appideasDOTcom/printery/images/A-Measurements.JPG

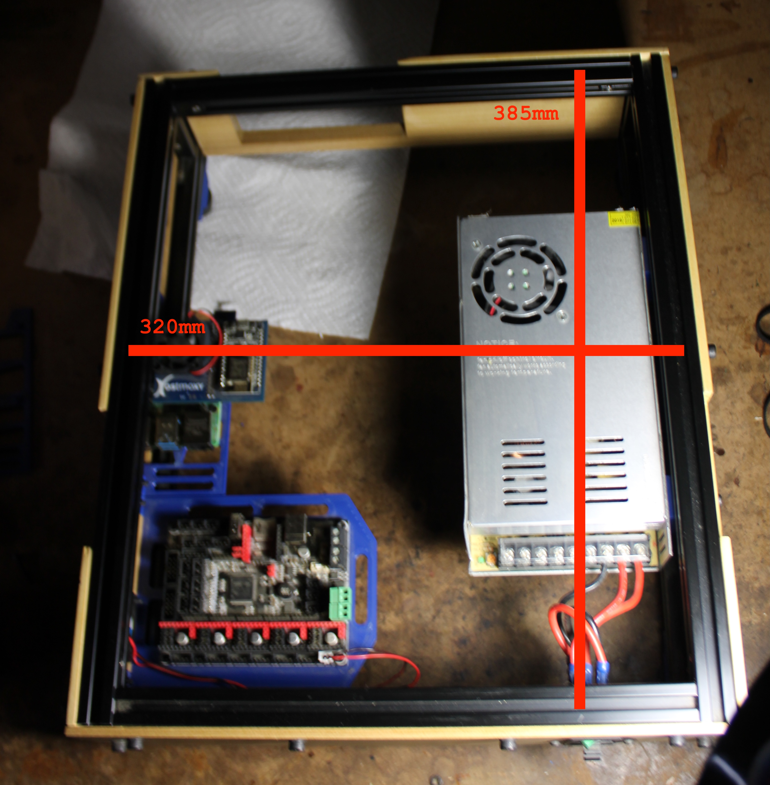
images/A-Measurements.JPG
