appideasDOTcom/printery/images/B-Electronics.JPG

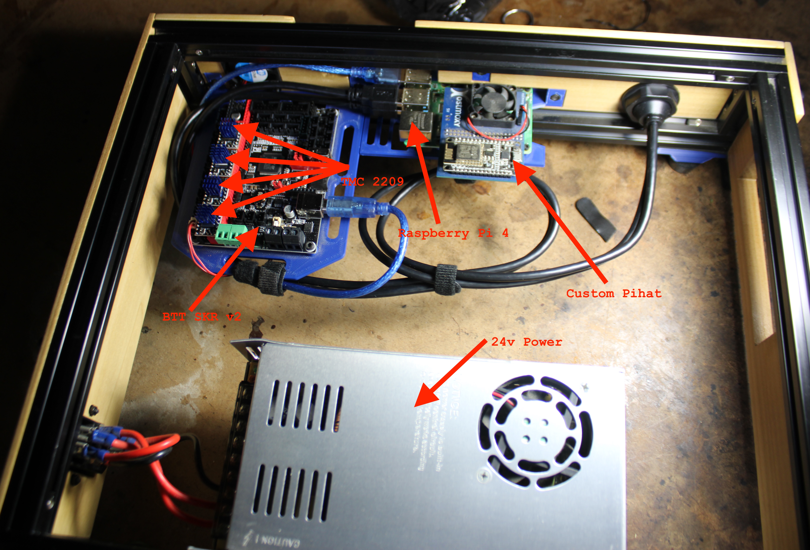
images/B-Electronics.JPG
