appideasDOTcom/printery/images/C-Front.JPG

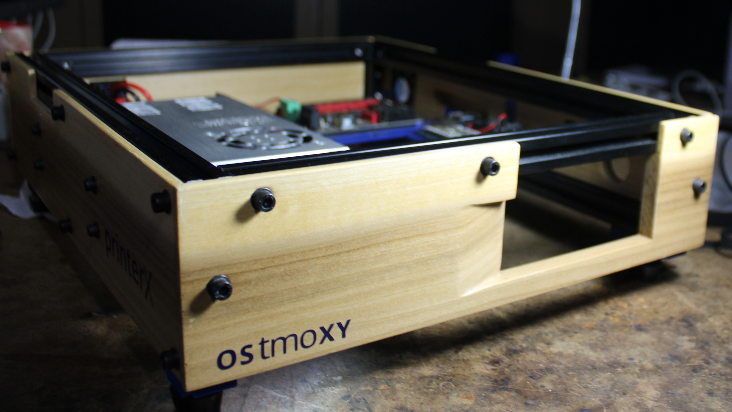
images/C-Front.JPG
