appideasDOTcom/printery/images/D-Right.JPG

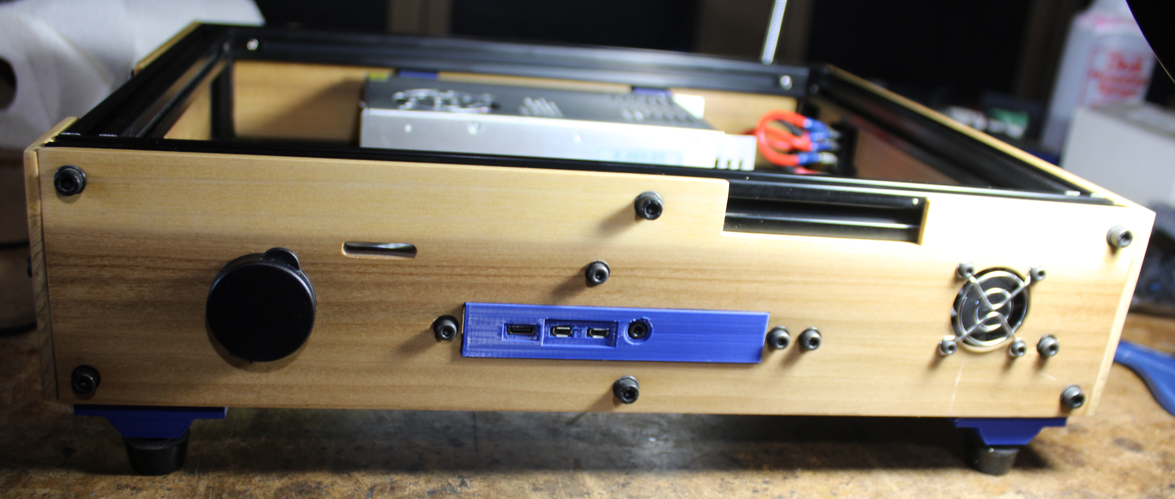
images/D-Right.JPG
