appideasDOTcom/printery/images/ZZ-Creality K1 Timing Belt Reference.png

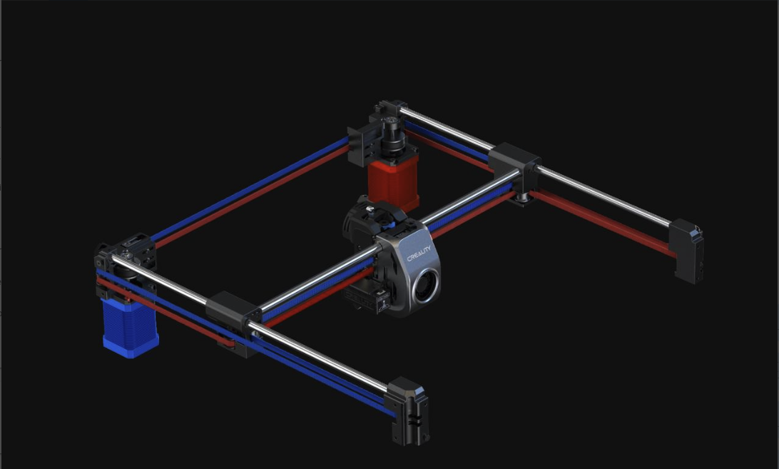
images/ZZ-Creality K1 Timing Belt Reference.png
