appideasDOTcom/printery/models/hotend/strain-gauge-interface.stl

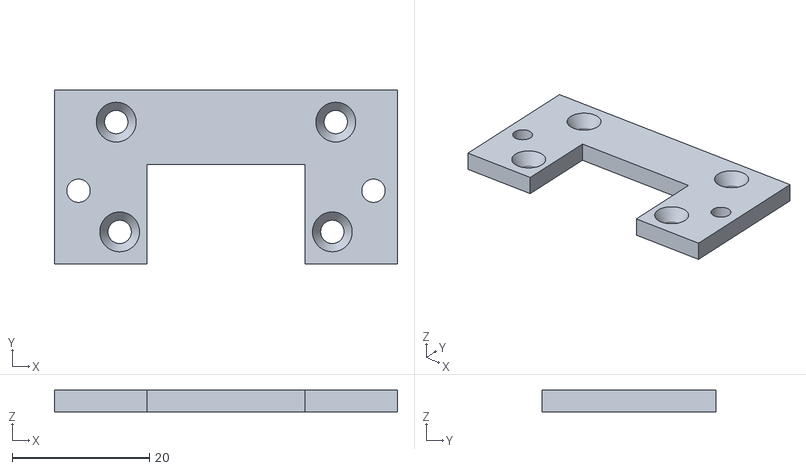
[picture p6: CAD file, 2026-07-26]
models/hotend/strain-gauge-interface.stl
50.0 x 25.4 x 3.20
