appideasDOTcom/printery/models/output/printerX/enclosure/Right panel.stl

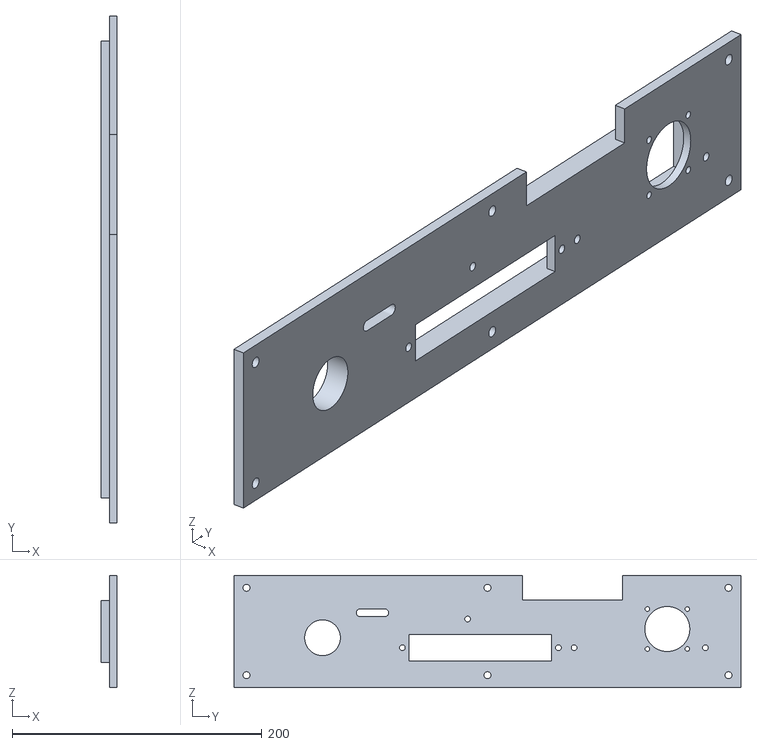
[picture p7: CAD file, 2026-06-04]
models/output/printerX/enclosure/Right panel.stl
12.9 x 406.0 x 90.0
