appideasDOTcom/printery/models/output/printerX/Z axis frame brace x4.stl

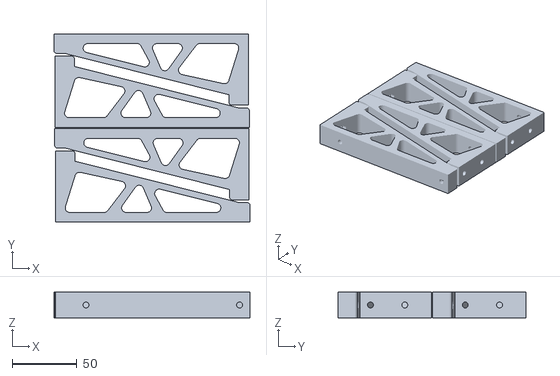
[picture p8: CAD file, 2026-06-19]
models/output/printerX/Z axis frame brace x4.stl
151.2 x 145.3 x 20.0
