appideasDOTcom/printery/models/output/y-rod-mount-A.stl

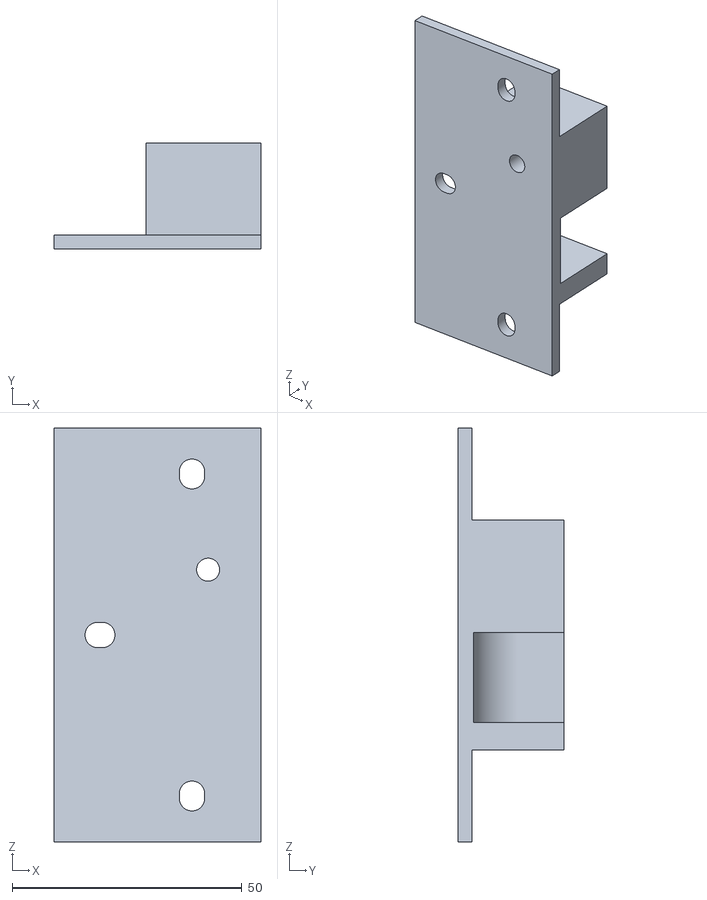
[picture p9: CAD file, 2026-07-26]
models/output/y-rod-mount-A.stl
45.0 x 23.0 x 90.0
