appideasDOTcom/printery/models/output/printerX/Z axis frame brace x2.stl

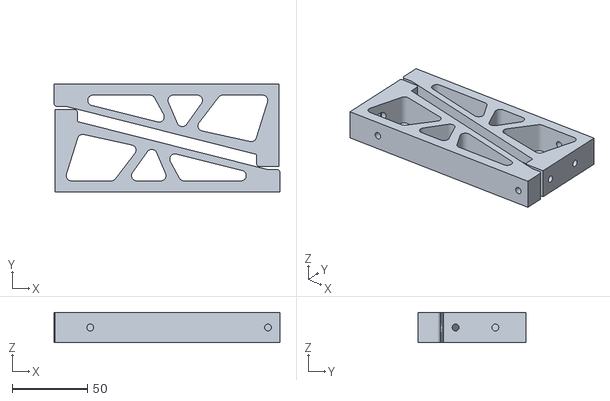
[picture p11: CAD file, 2026-06-19]
models/output/printerX/Z axis frame brace x2.stl
150.7 x 72.2 x 20.0
