appideasDOTcom/printery/models/output/printerX/enclosure/Front panel.stl

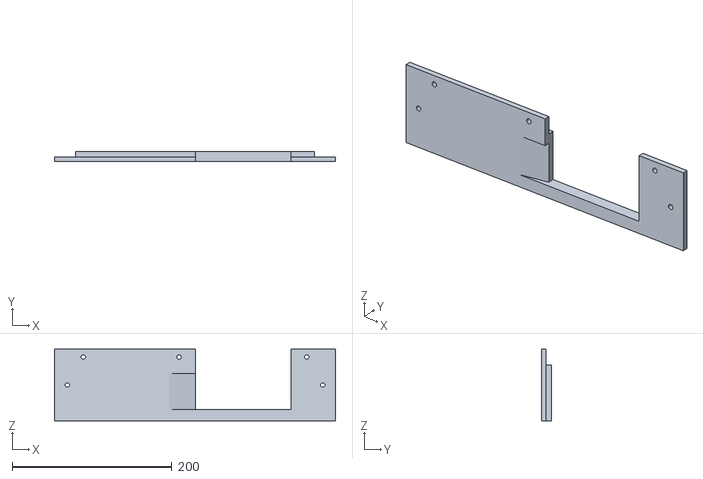
[picture p12: CAD file, 2026-06-04]
models/output/printerX/enclosure/Front panel.stl
352.0 x 12.9 x 90.0
