appideasDOTcom/printery/models/output/printerX/frame-pi-mount.stl

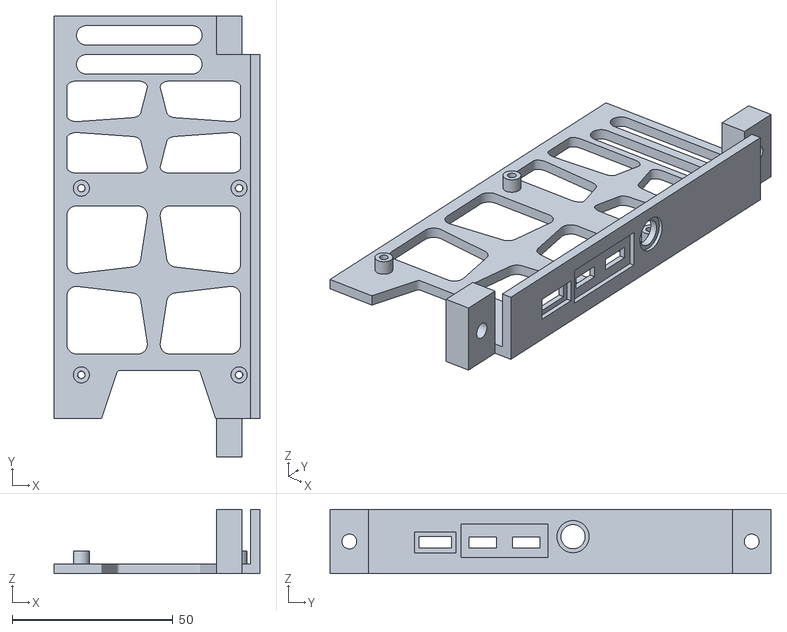
[picture p13: CAD file, 2026-06-18]
models/output/printerX/frame-pi-mount.stl
64.0 x 137.0 x 20.0
