appideasDOTcom/printery/models/output/printerX/enclosure/Top panel.stl

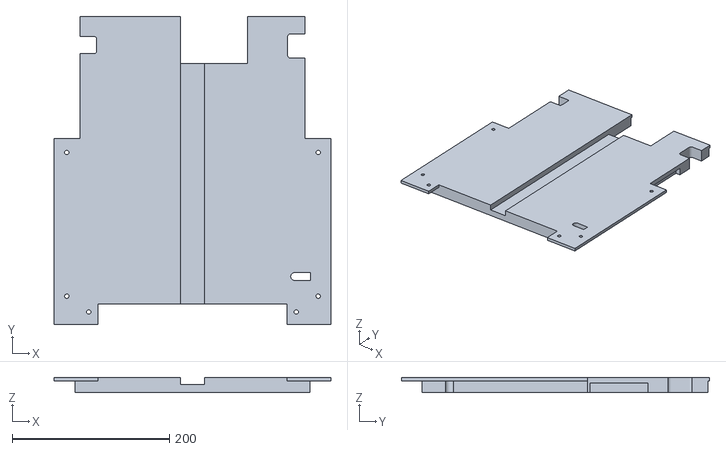
[picture p14: CAD file, 2026-06-04]
models/output/printerX/enclosure/Top panel.stl
352.0 x 392.0 x 19.2
