appideasDOTcom/printery/models/output/printerX/frame-controller-mount.stl

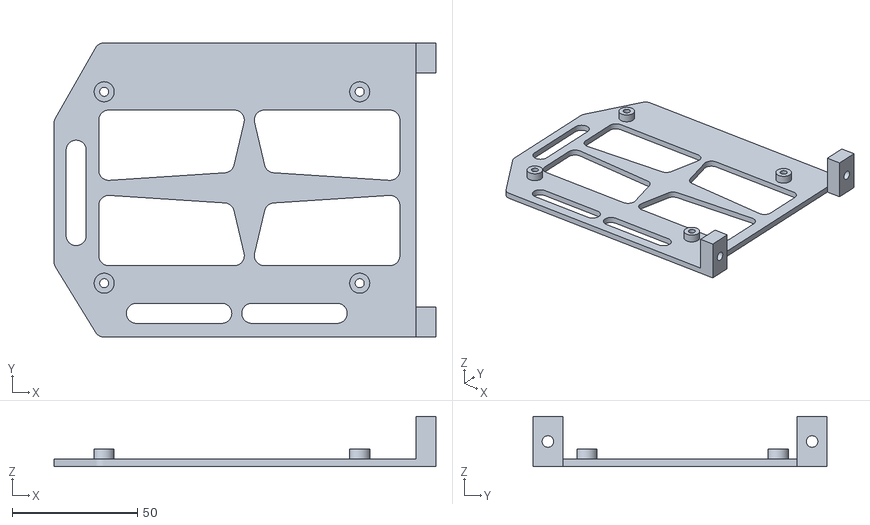
[picture p15: CAD file, 2026-06-18]
models/output/printerX/frame-controller-mount.stl
152.2 x 117.3 x 20.0
