appideasDOTcom/printery/models/output/printerX/frame-psu-mount-block.stl

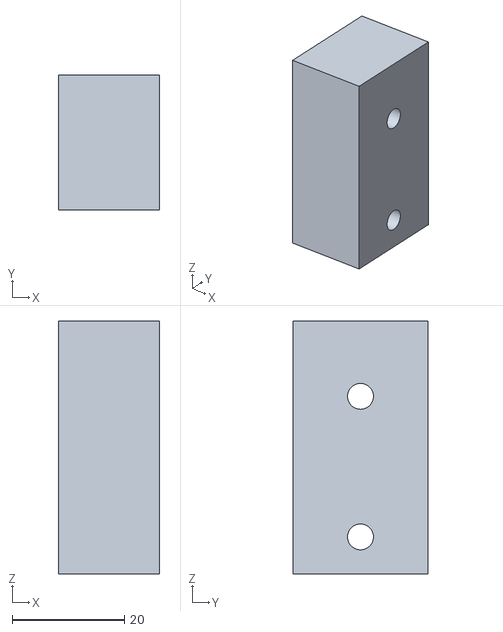
[picture p16: CAD file, 2026-06-18]
models/output/printerX/frame-psu-mount-block.stl
18.0 x 24.0 x 45.0
