appideasDOTcom/printery/models/output/z-belt-tensioner.stl

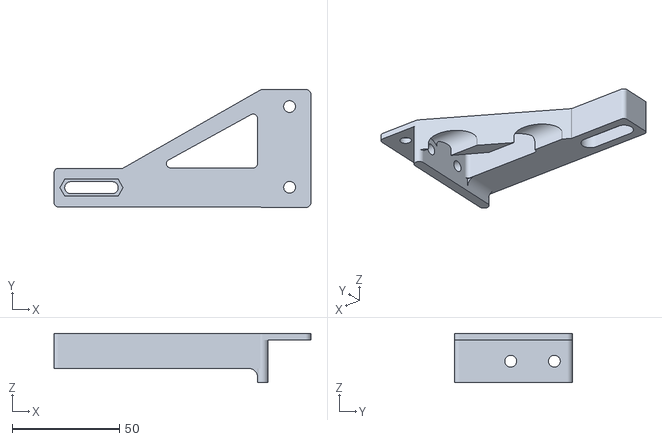
[picture p17: CAD file, 2026-06-29]
models/output/z-belt-tensioner.stl
120.0 x 55.2 x 23.0
