appideasDOTcom/printery/models/output/front-crossbar-AB.stl

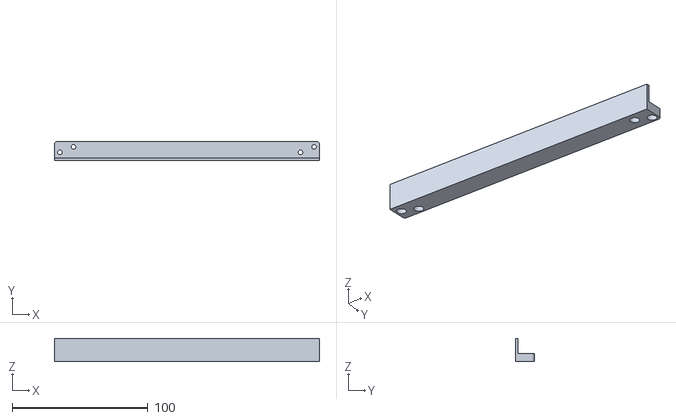
[picture p18: CAD file, 2026-06-27]
models/output/front-crossbar-AB.stl
195.0 x 14.0 x 17.2
