appideasDOTcom/printery/models/output/printerX/frame-tft-mount.stl

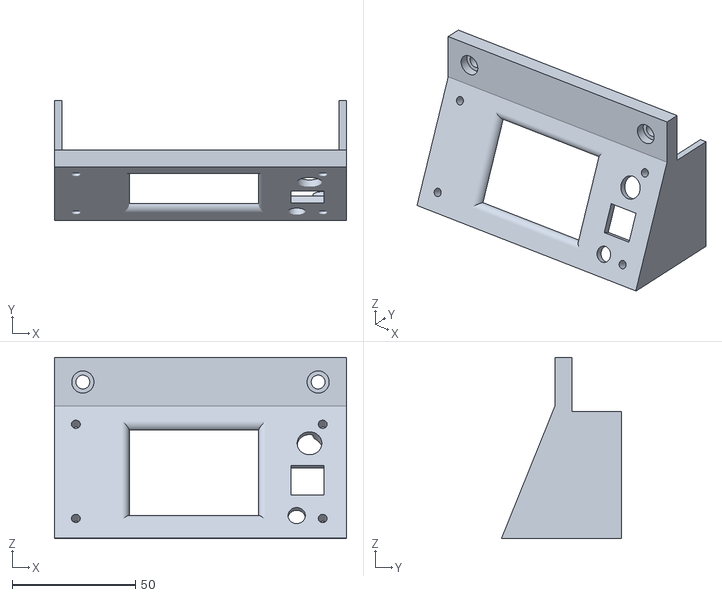
[picture p19: CAD file, 2026-06-18]
models/output/printerX/frame-tft-mount.stl
118.4 x 48.6 x 73.5
