appideasDOTcom/printery/models/output/printerX/Z axis frame brace.stl

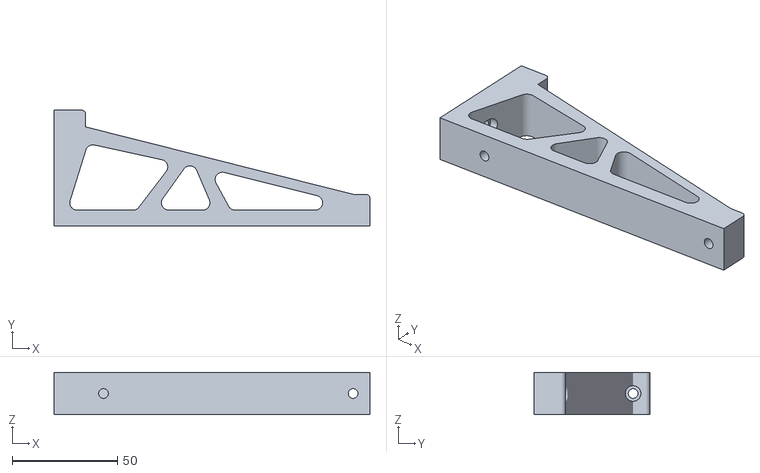
[picture p20: CAD file, 2026-06-04]
models/output/printerX/Z axis frame brace.stl
150.0 x 55.0 x 20.0
