appideasDOTcom/printery/models/output/z-carriage-sled-LEFT.stl

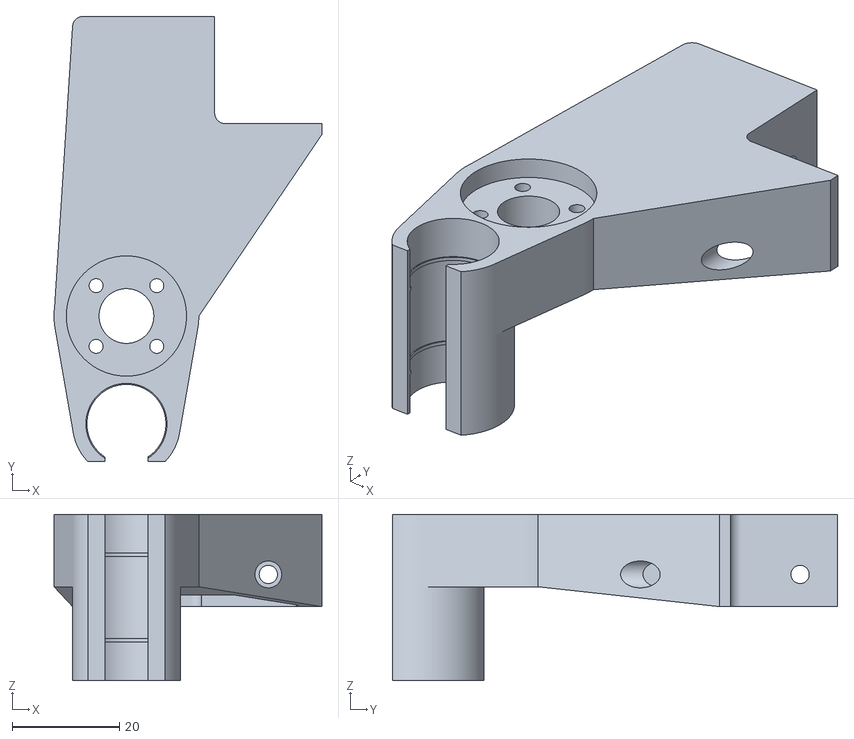
[picture p21: CAD file, 2026-06-27]
models/output/z-carriage-sled-LEFT.stl
50.0 x 83.0 x 31.0
