appideasDOTcom/printery/models/output/corner-bracket-D.stl

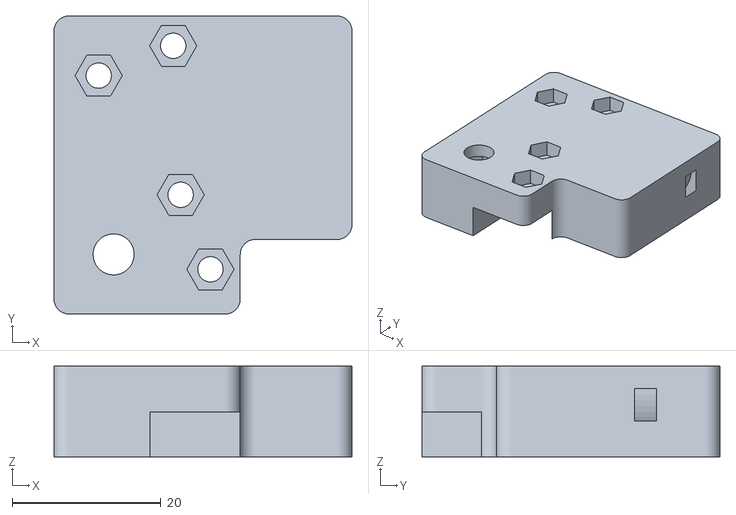
[picture p22: CAD file, 2026-06-27]
models/output/corner-bracket-D.stl
40.0 x 40.0 x 12.2
