appideasDOTcom/printery/models/output/printerX/Frame foot mount.stl

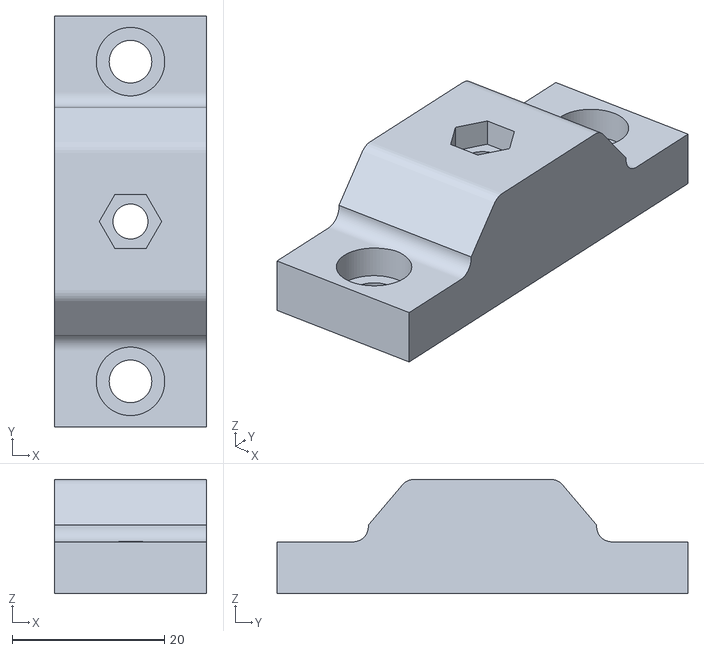
[picture p23: CAD file, 2026-06-04]
models/output/printerX/Frame foot mount.stl
20.0 x 54.0 x 15.0
