appideasDOTcom/printery/models/output/corner-bracket-B.stl

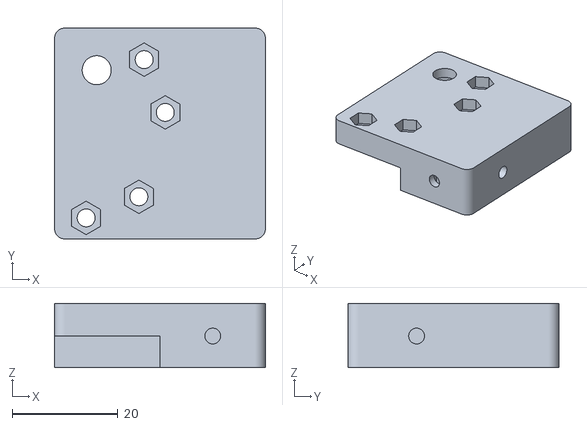
[picture p24: CAD file, 2026-06-27]
models/output/corner-bracket-B.stl
40.0 x 40.0 x 12.2
