appideasDOTcom/printery/models/output/corner-bracket-A.stl

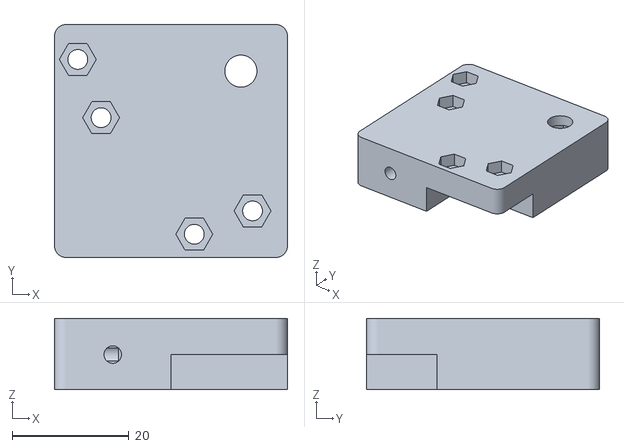
[picture p25: CAD file, 2026-06-27]
models/output/corner-bracket-A.stl
40.0 x 40.0 x 12.2
