appideasDOTcom/printery/models/output/printerX/608 bearing spacer.stl

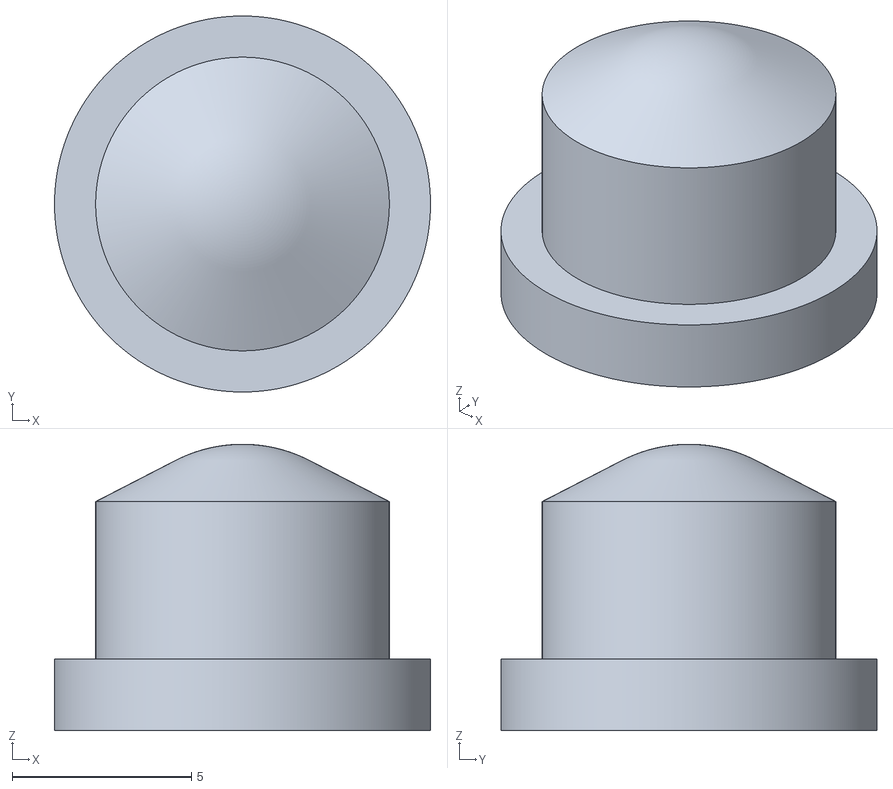
[picture p26: CAD file, 2026-06-03]
models/output/printerX/608 bearing spacer.stl
10.5 x 10.5 x 8.00
