appideasDOTcom/printery/models/output/corner-bracket-C.stl

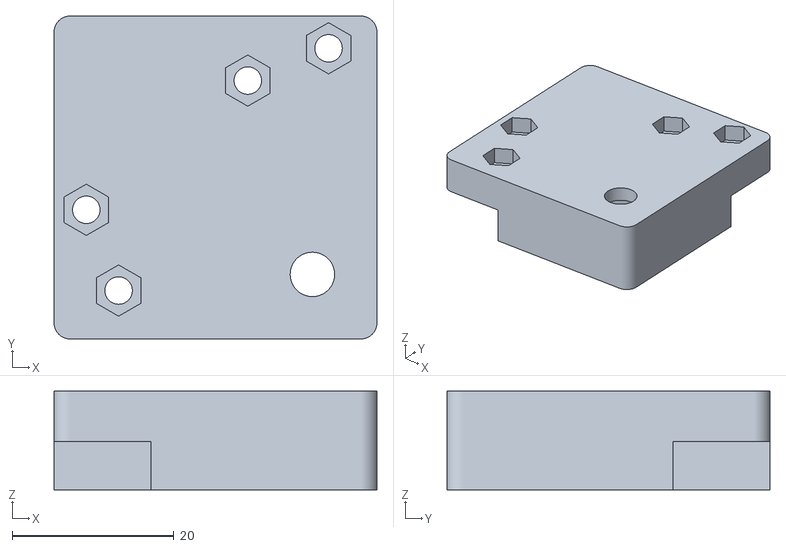
[picture p27: CAD file, 2026-06-27]
models/output/corner-bracket-C.stl
40.0 x 40.0 x 12.2
