appideasDOTcom/printery/models/output/printerX/608 bearing spacer x6.stl

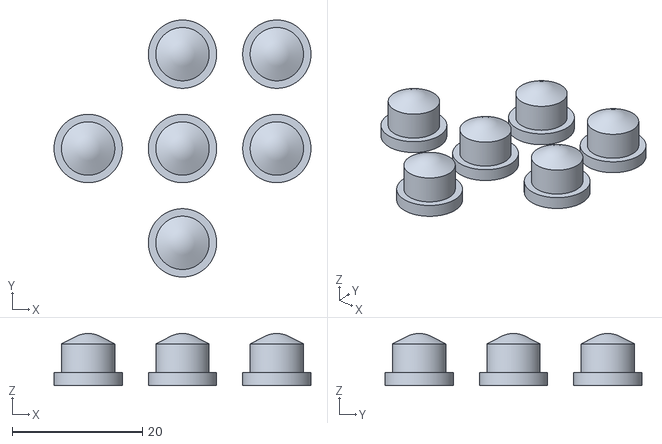
[picture p28: CAD file, 2026-06-03]
models/output/printerX/608 bearing spacer x6.stl
39.5 x 39.5 x 8.00
