appideasDOTcom/printery/models/output/z-carriage-sled-REAR.stl

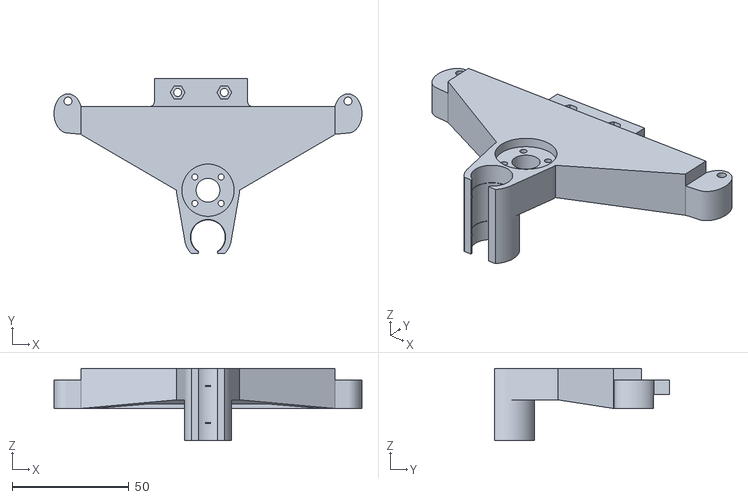
[picture p29: CAD file, 2026-06-27]
models/output/z-carriage-sled-REAR.stl
132.0 x 75.0 x 31.0
