appideasDOTcom/printery/models/output/front-crossbar-C.stl

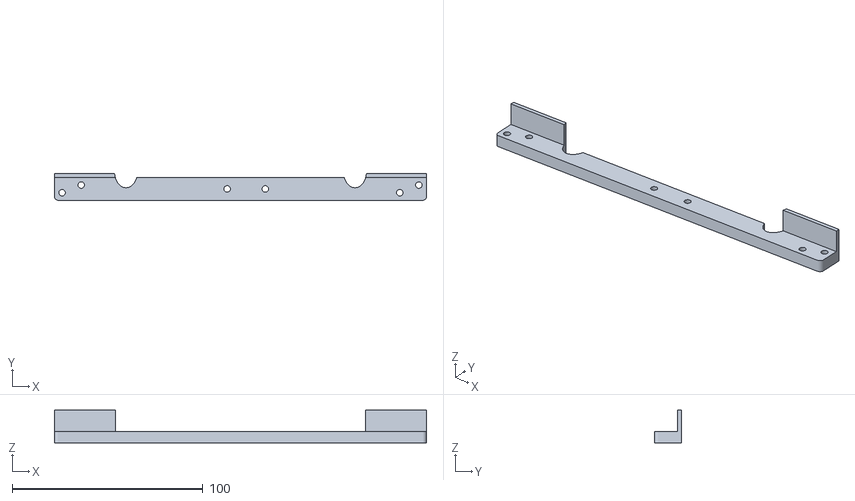
[picture p30: CAD file, 2026-06-26]
models/output/front-crossbar-C.stl
195.0 x 14.0 x 17.2
