appideasDOTcom/printery/models/output/front-crossbar-D.stl

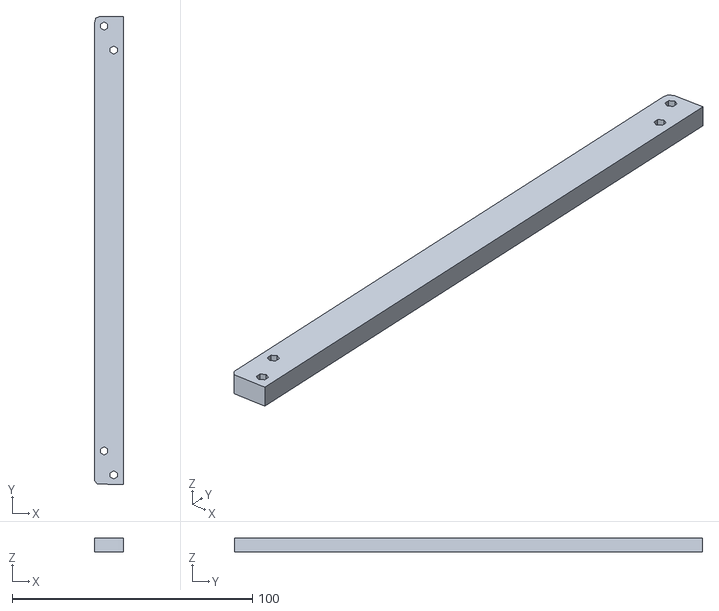
[picture p31: CAD file, 2026-06-22]
models/output/front-crossbar-D.stl
11.9 x 195.0 x 6.00
