appideasDOTcom/printery/models/output/z-pillow-block-C.stl

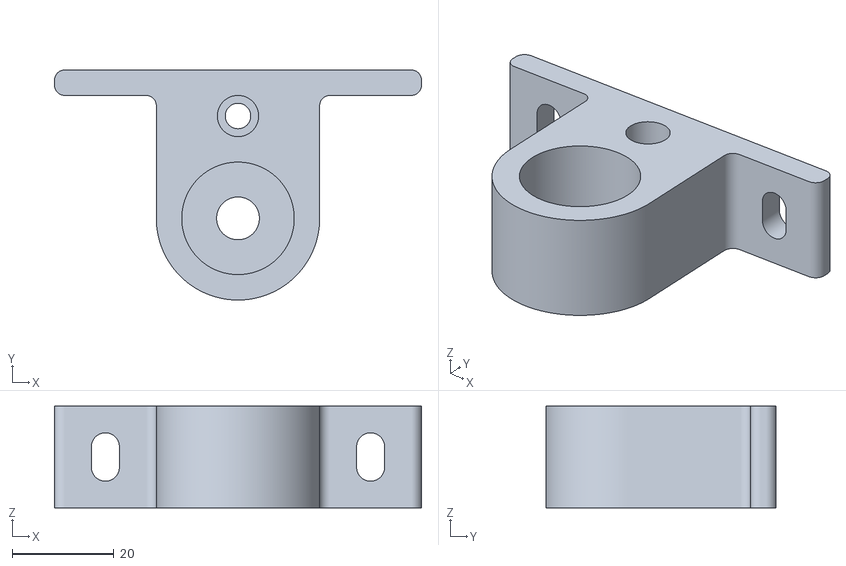
[picture p32: CAD file, 2026-06-17]
models/output/z-pillow-block-C.stl
72.1 x 45.2 x 20.0
