appideasDOTcom/printery/models/output/z-pillow-block-A.stl

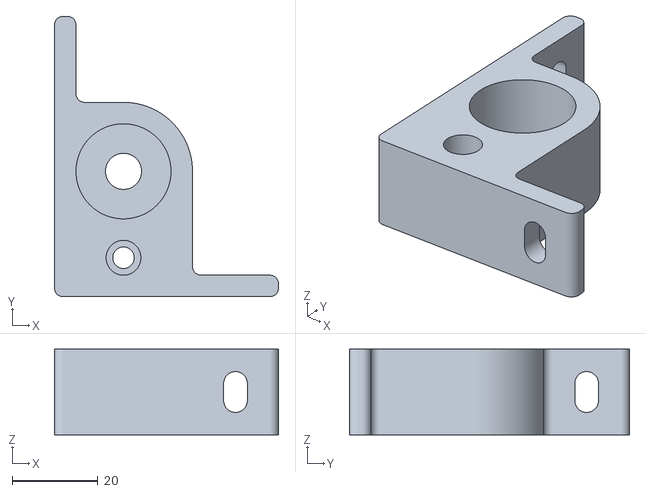
[picture p33: CAD file, 2026-06-17]
models/output/z-pillow-block-A.stl
52.1 x 65.2 x 20.0
