appideasDOTcom/printery/models/output/pulley-spacer-10.0mm.stl

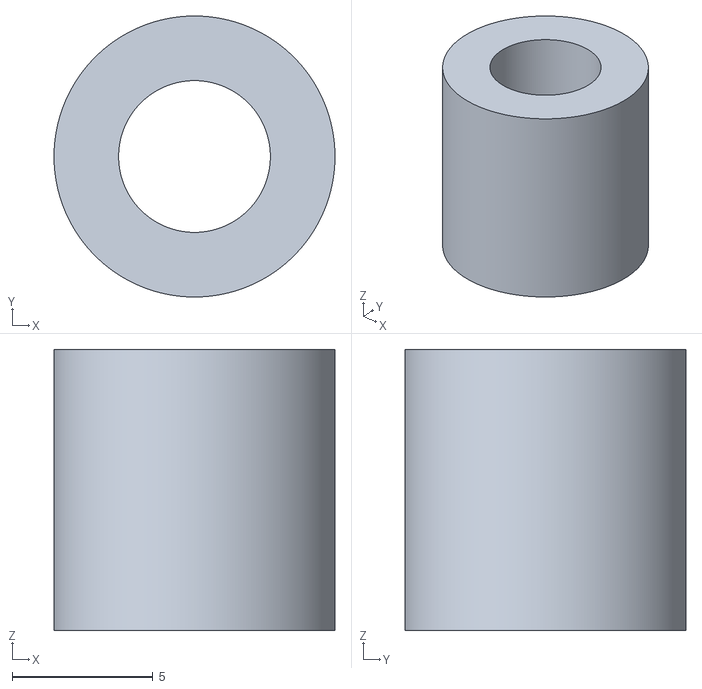
[picture p34: CAD file, 2026-06-17]
models/output/pulley-spacer-10.0mm.stl
10.00 x 10.00 x 10.0
