appideasDOTcom/printery/models/output/pulley-spacer-1.2mm.stl

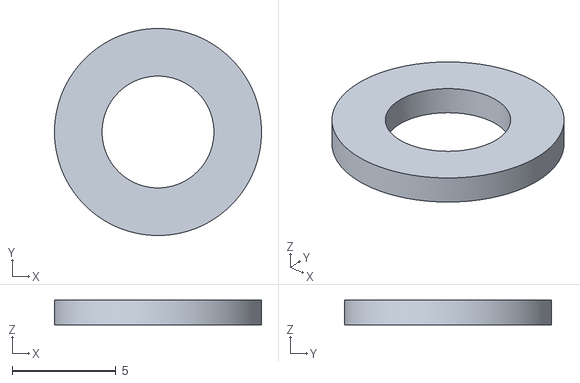
[picture p35: CAD file, 2026-06-17]
models/output/pulley-spacer-1.2mm.stl
10.00 x 10.00 x 1.20
