appideasDOTcom/printery/models/output/z-carriage-sled.stl

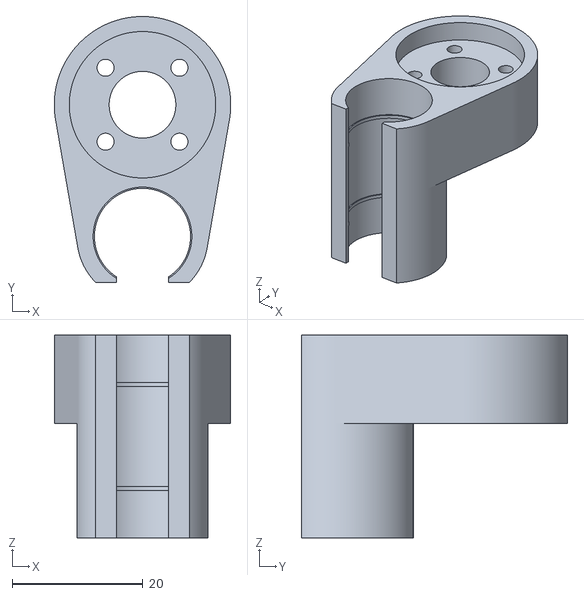
[picture p36: CAD file, 2026-06-17]
models/output/z-carriage-sled.stl
27.0 x 40.7 x 31.0
