appideasDOTcom/printery/models/output/pulley-spacer-SET.stl

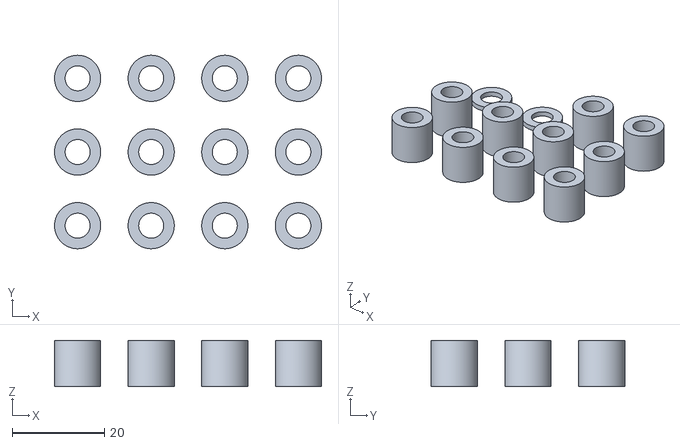
[picture p37: CAD file, 2026-06-17]
models/output/pulley-spacer-SET.stl
57.8 x 41.9 x 10.0
