appideasDOTcom/printery/models/output/x-rod-sled-RIGHT.stl

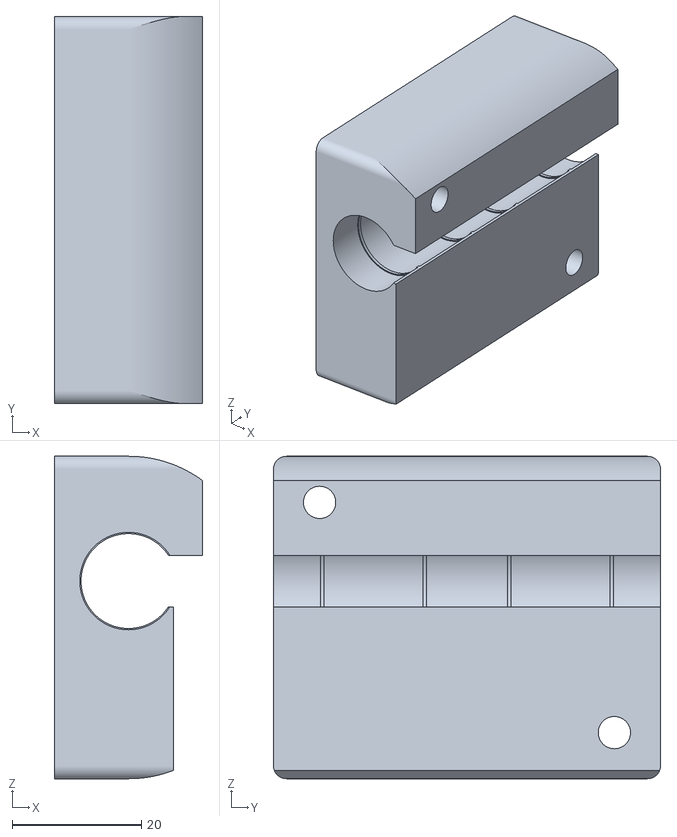
[picture p38: CAD file, 2026-06-12]
models/output/x-rod-sled-RIGHT.stl
23.0 x 60.0 x 50.0
