appideasDOTcom/printery/models/output/2020-extrusionx50mm.stl

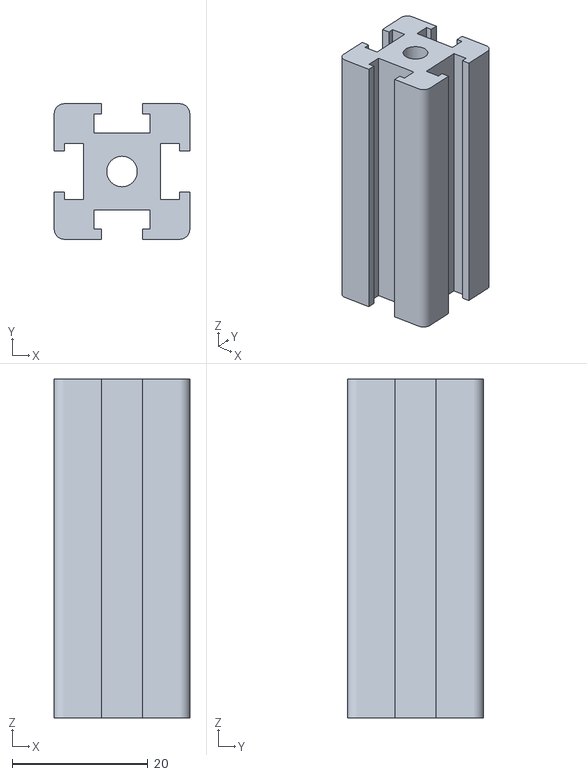
[picture p39: CAD file, 2026-06-03]
models/output/2020-extrusionx50mm.stl
20.0 x 20.0 x 50.0
