appideasDOTcom/printery/models/motion-system/z-belt-tensioner.scad

/**
 * z-belt-tensioner.scad
 *
 * Z-axis belt tensioner — mounts flat against the inner face of the right Y
 * extrusion (global X = bf_outer_x − ex = 320 mm), immediately behind (in +Y)
 * the front-right lower Z pillow block.
 *
 * Physical layout:
 *   The bracket is a vertical plate that presses against the X=320 face.
 *   Two M5 T-nut bolts (in X) clamp it to the extrusion.
 *   An arm extends inward (−X) at the belt's Z height, carrying a vertical
 *   M5 pulley shaft.  The shaft slot runs in X so the pulley can be pushed
 *   inward to tension the belt, then locked with a nut.
 *
 * Belt geometry (pulley centres, r = 6 mm):
 *   Rear-centre (170, 377) → Front-right (312, 28).  ΔX=142, ΔY=−349.
 *   At Y = 75 mm (mid-bracket):  t = (377−75)/349 = 0.866
 *     belt centreline X = 170 + 142×0.866 = 293 mm
 *     belt surface X    = 293 + 6         = 299 mm
 *   Extrusion inner face at X=320 → belt is 21 mm inboard.
 *
 * Pulley travel:
 *   Slot start (first contact): pulley centre X = 299 mm → 21 mm from face
 *   Slot end   (+15 mm travel): pulley centre X = 284 mm → 36 mm from face
 *
 * Placement in top-frame.scad:
 *   translate([bf_outer_x - ex, ex + z_lr_block_depth, pb_lower_bot_z])
 *     z_belt_tensioner();
 *   (local X=0 is the extrusion inner face; body extends in −X)
 */

include <../common/shared-dims.scad>

// ---------------------------------------------------------------------------
// Geometry
// ---------------------------------------------------------------------------

// Back plate: presses flat against X=320 face
_plate_x   = wing_t;  // thickness in X — matches Z pillow block wing thickness
_arm_y_start = 12.0;  // extension on each side of the arm
_plate_z   = ex;  // 23 mm — matches 2020 extrusion height

// Arm: extends inward (−X) from the back plate, at belt Z height.
// The arm is positioned at the REAR of the plate (away from the pillow block)
// so it does not overlap the pillow block in Y at all.
// Arm Z centre in local coords (local Z=0 = pb_lower_bot_z = 70 mm):
_arm_thick  = 16.4;  // arm height in Z
_arm_z_ctr  = ex - _arm_thick / 2;   // 15 mm — arm top flush with top of 20 mm extrusion
_arm_depth  = 95.0;  // arm reach in −X (must reach 80 mm for full slot travel)
_arm_y      = 18.0;  // arm front-to-back depth in Y (narrower than plate)
_plate_y    = _arm_y_start + _arm_y + _arm_y_start;  // 42 mm — equal extension on both sides of arm

// M5 pulley slot in the arm — vertical bolt (Z axis), slot runs in X
// Slot centre from the +X face (extrusion face):
//   first contact = 21 mm inboard → local X = −21  (arm local: 36 − 21 = 15 mm from tip)
//   end of travel = 36 mm inboard → local X = −36  (at arm tip)
// In arm-local coords (arm X=0 at plate back face, arm extends to X=−_arm_depth):
// _slot_near   = 21.0;   // mm inboard from extrusion face for first belt contact
// _slot_far    = 36.0;   // mm inboard for full 15 mm travel

_slot_near   = 65.0;   // mm inboard from extrusion face for first belt contact
_slot_far    = 90.0;   // mm inboard for full 15 mm travel

_slot_r      = m5_through_dia / 2 - 0.45 + 0.50;  // 2.75 mm + 0.45 for a little tolerance and to simplify the shape.
_slot_len    = _slot_far - _slot_near;  // 15 mm
// Arm-local X of slot centre (arm X=0 at extrusion face, negative = inboard):
_slot_cx_arm = -(_slot_near + _slot_len / 2);  // −28.5 mm

// M5 head counterbore on top face of arm
_cbore_d     = m5_head_dia;    // 9 mm
_cbore_z     = m5_head_depth + 3;  // 6.5 mm

// M5 nut trapping track — cut into the top of the arm, centred on the slot
_nut_track_w = 7.9;   // M5 nut narrow-side width
_nut_track_d = 3.4;   // depth of track from top surface
_nut_hex_dia = 9.1;   // M5 hex nut end-cap diameter

// Two M5 T-nut bolts clamping plate to extrusion (bolt axis in X, into T-slot)
_bolt_y1     = _plate_y * 0.25;
_bolt_y2     = _plate_y * 0.75;
_bolt_z1     = _plate_z * 0.25;
_bolt_z2     = _plate_z * 0.75;

// ---------------------------------------------------------------------------
// Module — local origin at the extrusion inner face (X=0 here = global X=320)
//          body extends in −X; placed with translate so X=0 lands on the face
// ---------------------------------------------------------------------------
_r = 2.0;
_f = 4.0;

_left_offset = 12.2;

module _top_wall() {
	hull() {

		translate([-_plate_x/2, _r, _arm_thick + 3.6])
            cylinder(r = _plate_x/2, h = 3);

		translate([-_plate_x/2, _plate_y - _r + _left_offset, _arm_thick + 3.6])
            cylinder(r = _plate_x/2, h = 3);

		translate([-_plate_x/2 + 20, _r, _arm_thick + 3.6])
            cylinder(r = _plate_x/2, h = 3);

		translate([-_plate_x/2 + 20, _plate_y - _r + _left_offset, _arm_thick + 3.6])
            cylinder(r = _plate_x/2, h = 3);
	}
}

// _supprt_structure();

module _supprt_structure() {

	difference() {

		translate([-2.5, _plate_y - _r + _left_offset, ex - _arm_thick + 3])
		{
			hull() {
				cylinder(r = _plate_x/2, h = _arm_thick);

				translate( [-_slot_near, -_plate_y + 5, 0] )
					cylinder(r = _plate_x/2, h = _arm_thick);

				translate( [0, -_plate_y + 5, 0] )
					cylinder(r = _plate_x/2, h = _arm_thick);

			}
		}

		translate([0 - 7, _arm_y + 7, ex - _arm_thick + 3 - 1])
		{

			hull() {
				translate( [0, -5, 0] )
					cylinder(r = 2, h = _arm_thick + 2);

				translate( [-_slot_near/2 - 6, -5, 0] )
					cylinder(r = 2, h = _arm_thick + 2);


				translate( [0, _left_offset + 4, 0] )
					cylinder(r = 2, h = _arm_thick + 2);
			}
		}


	}

}

module _fillet_corner(y, rear = false) {
    // Quarter-torus patch between the perpendicular side and bottom fillets.
    // Its section grows from zero at their shared outer point to the full
    // corner radius at the plate, so it occupies only the gap between them.
    _steps = 24;
    intersection() {
        translate([-_plate_x - _f, y, _arm_z_ctr - _arm_thick/2])
            rotate([0, 90, 0])
                rotate_extrude()
                    polygon(concat(
                        [[0, 0]],
                        [for (i = [1:_steps])
                            let(x = _f * i / _steps)
                                [_f - sqrt(_f*_f - x*x), x]],
                        [[0, _f]]
                    ));
        translate([-_plate_x - _f, rear ? y : y - _f,
                   _arm_z_ctr - _arm_thick/2 - _f])
            cube([_f, _f, _f]);
    }
}

module z_belt_tensioner() {

    difference() {
        union() {
			_top_wall();
			_supprt_structure();
            // Back plate — full height, corners rounded via hull of cylinders
            hull() {
                translate([-_plate_x/2, _r, 0])
                    cylinder(r = _plate_x/2, h = _plate_z + 3);
                translate([-_plate_x/2, _plate_y - _r + _left_offset, 0])
                    cylinder(r = _plate_x/2, h = _plate_z + 3);


            }

            // Arm — at its Z position, all four outer corners rounded as one shape
            translate([0, -_left_offset, _arm_z_ctr - _arm_thick/2 + 3])
                linear_extrude(_arm_thick)
                    offset(r = _r) offset(r = -2*_r) offset(r = _r)
                        translate([-_plate_x - _arm_depth, _arm_y_start])
                            square([_arm_depth + _plate_x, _arm_y]);

            // Bottom fillet: arm underside meets back plate (XZ plane, extruded in Y)
            translate([-_plate_x - 4, _arm_y_start - _left_offset + 2, _arm_z_ctr - _arm_thick/2 - _f + 3])
                rotate([-90, -90, 0])
                    linear_extrude(_arm_y - 2)
                        difference() {
                            square([_f, _f]);
                            circle(r = _f);
                        }

            // Close the two trihedral gaps between the side and bottom fillets.
            // translate( [0, 0, 3] )
			// 	_fillet_corner(_arm_y_start + _arm_y - _left_offset, rear = true);

            // Inner fillets at arm-to-plate junctions
            // translate([0, 0, _arm_z_ctr - _arm_thick/2])
            //     linear_extrude(_arm_thick) {
            //         // Rear junction: corner at (-_plate_x, _arm_y_start+_arm_y)
            //         translate([-2*_plate_x - _f, 2*(_arm_y_start + _arm_y) + _f - _left_offset])
            //         rotate([0, 0, -180])
            //         difference() {
            //             translate([-_plate_x - _f, _arm_y_start + _arm_y])
            //                 square([_f, _f]);
            //             translate([-_plate_x, _arm_y_start + _arm_y])
            //                 circle(r = _f);
            //         }
            //     }
        }

        // M5 pulley slot — vertical (Z axis), slot runs in X
        // Y centred on the arm (rear portion of plate)
        _arm_cy = (_arm_y_start + _arm_y / 2);
        translate([_slot_cx_arm - _plate_x, _arm_cy - _left_offset, _arm_z_ctr - _arm_thick/2 - 0.1 + 3])
            hull() {
                translate([-(_slot_len/2 - _slot_r), 0, 0])
                    cylinder(r = _slot_r, h = _arm_thick + 0.2);
                translate([ (_slot_len/2 - _slot_r), 0, 0])
                    cylinder(r = _slot_r, h = _arm_thick + 0.2);
            }

        // M5 through hole in rear plate extension — centre of rear section
        translate([0, _arm_y_start + _arm_y + _arm_y_start / 2 + _left_offset - 2, _plate_z / 2])
		{
            rotate([0, -90, 0])
			{
                cylinder(d = m5_through_dia, h = _plate_x + 0.2);
					translate( [0, 0, 5] )
						hull() {
							cylinder(d = m5_through_dia + 6, h = 80);
							translate( [-10, 0, 0] ) cylinder(d = m5_through_dia + 6, h = 80);
						}

			}
		}

		translate([0, _arm_y_start + _arm_y + _arm_y_start / 2 - _left_offset + 2, _plate_z / 2])
		{
            rotate([0, -90, 0])
			{
                cylinder(d = m5_through_dia, h = _plate_x + 0.2);
					translate( [0, 0, 5] )
						hull() {
							cylinder(d = m5_through_dia + 6, h = 80);
							translate( [-10, 0, 0] ) cylinder(d = m5_through_dia + 6, h = 80);
						}
			}
		}

		translate([10, _arm_y/2, _plate_z - 0.1]) {
			cylinder(d = m5_through_dia, h = _plate_x + 0.2);
			translate( [0, _arm_y_start + _arm_y + _left_offset - (_arm_y/4), 0] ) cylinder(d = m5_through_dia, h = _plate_x + 0.2);
		}




        // M5 head counterbore from bottom of arm
        translate([_slot_cx_arm - _plate_x, _arm_cy - _left_offset, _arm_z_ctr - _arm_thick/2 - 0.1 + 3])
            hull() {
                translate([-(_slot_len/2 - _slot_r + 0.5), 0, 0])
                    cylinder(d = _cbore_d, h = _cbore_z + 0.1);
                translate([ (_slot_len/2 - _slot_r + 0.5), 0, 0])
                    cylinder(d = _cbore_d, h = _cbore_z + 0.1);
            }

        // M5 nut trapping track — straight channel from top surface down
        translate([_slot_cx_arm - _plate_x - _slot_len/2,
                   (_arm_cy - _nut_track_w/2) - _left_offset,
                   _plate_z - _nut_track_d + 3])
            cube([_slot_len, _nut_track_w, _nut_track_d + 0.1]);

        // Hex end caps — points face ±Y (in/out of printer), rotate 90° around Z
        _nut_track_z = _plate_z - _nut_track_d;
        rotate([0, 0, 90])
            for (ex = [_slot_cx_arm - _plate_x - _slot_len/2 + _slot_r - 0.5,
                       _slot_cx_arm - _plate_x + _slot_len/2 - _slot_r + 0.5]) {
                translate([_arm_cy - _left_offset, -ex, _nut_track_z + 3])
					rotate([0, 0, 90])
                    	cylinder(d = _nut_hex_dia, h = _nut_track_d + 0.1, $fn = 6);
            }

    }
}

// ---------------------------------------------------------------------------
// Preview
// ---------------------------------------------------------------------------
z_belt_tensioner();
