appideasDOTcom/printery/(list of files, cad)

Other CAD files:
models/output/y-rod-mount-D.stl
models/output/y-rod-mount-C.stl
models/output/y-rod-mount-B.stl
models/output/z-carriage-sled-RIGHT.stl
models/output/printerX/TFT mount.stl
models/output/z-pillow-block-B.stl
models/output/x-rod-sled-LEFT.stl
models/frame/x-rod-sled.scad
models/frame/y-rod-mount.scad
models/frame/z-carriage-sled.scad
models/frame/z-pillow-block.scad
models/hotend/hotend-carriage.scad
models/output/printerX/Frame foot mount - buried nut.stl
models/printerX/Shared-modules.scad
models/printerX/Z axis frame brace.scad
