appideasDOTcom/printery/models/Extrusion Measurements.md

## Lower Frame + Top Frame + Upper-Top Frame — 2020 Extrusion Cuts

### Lower Frame

| Qty | Length | Description |
|-----|---|---|
| 4 | **405 mm** | Bottom Y rails (left & right) |
| 2 | **300 mm** | Bottom X cross-members (front & rear) |
| 4 | **50 mm** | Corner posts |

### Top Frame

| Qty | Length | Description |
|-----|---|---|
| 4 | **336 mm** | Corner uprights (cut from 400 mm or 1 m stock) |
| 1 | **336 mm** | Center rear upright support |
| 2 | **405 mm** | Top Y rails (left & right) |
| 2 | **300 mm** | Top X cross-members (front & rear) |

### Upper-Top Frame

| Qty | Length | Description |
|-----|---|---|
| 4 | **50 mm** | Corner posts |
| 2 | **405 mm** | Top Y rails (left & right) |
| 2 | **300 mm** | Top X cross-members (front & rear) |

---

### Summary by length

| Length | Total Qty | Notes |
|---|---|---|
| 405 mm | 8 | Long (Y) axis rails |
| 336 mm | 5 | Top frame uprights and support beam |
| 300 mm | 6 | Short (X) axis rails |
| 50 mm  | 8 | UTF corner posts only |
