appideasDOTcom/printery/(commit log)

2026-06-01 2020 extrusion
    [2020-extrusion.scad]
2026-06-01 Commented preview extension
    [2020-extrusion.scad]
2026-06-01 Modeled bottom frame
    [bottom-frame.scad]
2026-06-02 WIP top frame
    [bottom-frame.scad, rod-end-capture.scad, shared-dims.scad, top-frame.scad, z-pillow-block.scad]
2026-06-02 Correct top frame and Z pillow blocks
    [shared-dims.scad, top-frame.scad, z-pillow-block.scad]
2026-06-02 WIP upper top frame modeling
    [shared-dims.scad, top-frame.scad, upper-top-frame.scad, y-rod-mount.scad]
2026-06-02 Prototyped frame and carriage
    [top-frame.scad, x-rod-sled.scad]
2026-06-02 Reasonably PoC top frame mechanisms + extrusion cut documentation
    [z-pillow-block-center.stl, z-pillow-block.scad, z-pillow-block.stl]
2026-06-03 Mostly rounded Z pillow block
    [z-pillow-block.scad]
2026-06-03 RC1 Z axis pillow blocks
    [shared-dims.scad, z-pillow-block-center.stl, z-pillow-block.scad, z-pillow-block.stl]
2026-06-03 Improved pillow blocks + borrowed flange from printerX
    [608 bearing flange x6.stl, 608 bearing flange.stl, z-pillow-block.scad]
2026-06-03 Comment preview + 50mm 2020 extrusion STL
    [2020-extrusionx50mm.stl, z-pillow-block.scad]
2026-06-04 - Reduced pillow block cutout diameter - Added center-rear support beam + documentation - Borrowed models from printerX
    [Frame foot mount - buried nut.stl, Frame foot mount.stl, Front panel.stl, Left panel.stl, Right panel.stl, TFT mount.stl, Top panel.stl, shared-dims.scad]
2026-06-04 Z axis frame brace from printerX
    [Shared-modules.scad, Z axis frame brace.scad, Z axis frame brace.stl]
2026-06-04 Rendered Z axis braces
    [top-frame.scad]
2026-06-04 Small refactor: Move top carriage to upper-top-frame
    [top-frame.scad, upper-top-frame.scad]
2026-06-06 Updated Z axis pillow block; Updated linear rod measurement; Electronics mount model
    [Light Electronics Mount.stl, shared-dims.scad, z-pillow-block-center.stl, z-pillow-block.scad, z-pillow-block.stl]
2026-06-06 Added lower frame extrusion measurements
2026-06-06 Added linear rods to Z axis pilow blocks
    [shared-dims.scad, top-frame.scad, z-pillow-block.scad]
2026-06-06 Updated Z pillow block output models
    [z-pillow-block-A.stl, z-pillow-block-B.stl, z-pillow-block-center.stl, z-pillow-block.scad, z-pillow-block.stl]
2026-06-08 Adjust liner rod bore hole diameter for precise fit
    [shared-dims.scad, z-pillow-block-A.stl, z-pillow-block-B.stl, z-pillow-block-center.stl]
2026-06-10 WIP sled and rails modeling
    [rod-end-capture.scad, shared-dims.scad, top-frame.scad, upper-top-frame.scad, x-rod-sled.scad, y-rod-mount.scad]
2026-06-10 Fixed x rod bores
    [upper-top-frame.scad]
2026-06-10 Updated Y rod sled
    [x-rod-sled.scad]
2026-06-10 WIP Y Rod mounts
    [upper-top-frame.scad, y-rod-mount.scad]
2026-06-11 WIP Y rod sled
    [shared-dims.scad, upper-top-frame.scad, x-rod-sled.scad]
2026-06-12 Move Y rods
    [shared-dims.scad, y-rod-mount.scad]
2026-06-12 WIP mounts and sleds
    [x-rod-sled.scad, y-rod-mount-A.stl, y-rod-mount.scad, y-rod-mount.stl]
2026-06-13 Updates Y rod mount
    [y-rod-mount-A.stl, y-rod-mount-B.stl, y-rod-mount-C.stl, y-rod-mount-D.stl, y-rod-mount.scad, y-rod-mount.stl]
2026-06-13 Front X rod sled pulley pocket
    [shared-dims.scad, x-rod-sled.scad]
2026-06-14 Potentially working X rod sled
    [x-rod-sled.scad]
2026-06-14 Refined X rod sled for no-support printing
    [x-rod-sled.scad]
2026-06-15 WIP hotend carriage
    [hotend-carriage.scad, upper-top-frame.scad]
2026-06-15 Initial shape with bearing retainers.
    [hotend-carriage.scad]
2026-06-15 Properly placed hotend carriage shape
    [hotend-carriage.scad, upper-top-frame.scad]
2026-06-15 Refactored scad models into sensical directory structure
    [hotend-carriage.scad, shared-dims.scad, top-frame.scad, upper-top-frame.scad, x-rod-sled.scad, y-rod-mount.scad, z-carriage-sled.scad, z-pillow-block.scad]
2026-06-17 Reduce linear rail pocket tolerance + refactor for easier updating; WIP models.
    [pulley-spacer-1.6mm.stl, pulley-spacer-10.2mm.stl, pulley-spacer-SET.stl, pulley-spacer.scad, shared-dims.scad, x-rod-sled.scad, y-rod-mount-C.stl, y-rod-mount.scad]
2026-06-17 Output models with corrected linear rail tolerance
    [pulley-spacer-1.2mm.stl, pulley-spacer-1.6mm.stl, pulley-spacer-10.0mm.stl, pulley-spacer-10.2mm.stl, pulley-spacer-SET.stl, pulley-spacer.scad, y-rod-mount-A.stl, y-rod-mount-B.stl]
2026-06-17 Adjust for less printing slop/smaller seams
    [shared-dims.scad, z-pillow-block-A.stl, z-pillow-block-B.stl, z-pillow-block-C.stl, z-pillow-block.scad]
2026-06-18 Light electronics mount for LM2596 buck converter; Additional models from printerX
    [Light Electronics Mount.stl, frame-controller-mount.stl, frame-pi-mount.stl, frame-psu-mount-block.stl, frame-tft-mount.stl]
2026-06-18 WIP Z belt tensioner
    [top-frame.scad, z-belt-tensioner.scad]
2026-06-18 Z belt tensioner mount, rev1
    [top-frame.scad, z-belt-tensioner.scad]
2026-06-18 WIP Z tensioner
    [z-belt-tensioner.scad]
2026-06-18 Correct fillet on Z belt tensioner
    [z-belt-tensioner.scad]
2026-06-18 Corrected fillet joining shape
    [z-belt-tensioner.scad]
2026-06-18 WIP Z belt adjustment refinement
    [z-belt-tensioner.scad, z-belt-tensioner.stl]
2026-06-18 Z belt tensioner nut trap refinement
    [z-belt-tensioner.scad]
2026-06-18 Z belt tensioner RC1
    [z-belt-tensioner.scad, z-belt-tensioner.stl]
2026-06-18 Z belt tensioner RC2
    [upper-top-frame.scad, z-belt-tensioner.scad, z-belt-tensioner.stl]
2026-06-19 Added an inner fillet + beginning of common shapes file.
    [shapes.scad]
2026-06-19 Clarify module comment
    [shapes.scad]
2026-06-19 Add models from printerX
    [Z axis frame brace x2.stl, Z axis frame brace x4.stl]
2026-06-19 WIP hot plate mounting
    [corner-bracket.scad, shared-dims.scad, top-frame.scad]
2026-06-20 WIP bed frame
    [corner-bracket.scad, front-crossbar.scad, right-crossbar.scad, top-frame.scad]
2026-06-20 WIP crossbars and corner bed mounting pieces
    [corner-bracket.scad, top-frame.scad]
2026-06-20 Change colors for easier sight
    [top-frame.scad]
2026-06-21 Adjusted hotbed brackets
    [corner-bracket.scad, front-crossbar.scad, top-frame.scad]
2026-06-22 Hotbed mount refinements
    [corner-bracket-A.stl, corner-bracket-B.stl, corner-bracket-C.stl, corner-bracket-D.stl, corner-bracket.scad, front-crossbar-AB.stl, front-crossbar-C.stl, front-crossbar-D.stl]
2026-06-25 Added cable tie to right-rear corner
    [corner-bracket-D.stl, corner-bracket.scad]
2026-06-25 WIP hotbed carriage connectors
    [top-frame.scad, upper-top-frame.scad, z-carriage-sled.scad]
2026-06-25 RC1 front left and right hotbed carriage
    [corner-bracket.scad, top-frame.scad, z-carriage-sled.scad]
2026-06-25 Insert and trap an M3 nut in the corner bracket
    [corner-bracket.scad, top-frame.scad, z-carriage-sled.scad]
2026-06-25 Reasonable brackets
    [corner-bracket.scad, z-carriage-sled.scad]
2026-06-25 Remove debug
    [z-carriage-sled.scad]
2026-06-25 Prototype print output
    [corner-bracket-A.stl, corner-bracket-B.stl, z-carriage-sled-LEFT.stl, z-carriage-sled-RIGHT.stl, z-carriage-sled.scad]
2026-06-25 Pass 1 variable refactor
    [corner-bracket.scad, shared-dims.scad, z-carriage-sled.scad]
2026-06-25 Pass 2 variable refactor.
    [corner-bracket.scad]
2026-06-26 WIP rear z carriage sled
    [corner-bracket-A.stl, corner-bracket-B.stl, corner-bracket.scad, front-crossbar.scad, top-frame.scad, z-carriage-sled.scad]
2026-06-26 Rear crossbar and carriage sled RC1
    [front-crossbar-C.stl, z-carriage-sled-REAR.stl, z-carriage-sled.scad]
2026-06-26 Update model variation output options
    [corner-bracket.scad, front-crossbar.scad, z-carriage-sled.scad]
2026-06-26 Update upper-top-frame to include build plate updates
    [upper-top-frame.scad]
2026-06-26 Updated comment
    [right-crossbar.scad]
2026-06-26 Remove thin wall for smoother printing
    [front-crossbar.scad, z-carriage-sled.scad]
2026-06-27 Output STLs for latest variants of hotbed mounts
    [corner-bracket-A.stl, corner-bracket-B.stl, corner-bracket-C.stl, corner-bracket-D.stl, front-crossbar-AB.stl, front-crossbar.scad, z-carriage-sled-LEFT.stl, z-carriage-sled-REAR.stl]
2026-06-27 new variant outputs for printable models from upper-top-frame (X rod sleds and Y rod mounts)
    [x-rod-sled.scad, y-rod-mount-A.stl, y-rod-mount-B.stl, y-rod-mount-C.stl, y-rod-mount-D.stl, y-rod-mount.scad]
2026-06-27 Better tolerance for bet tensioner
    [z-belt-tensioner.scad, z-belt-tensioner.stl]
2026-06-29 WIP Z tension adjustment
    [z-belt-tensioner.scad]
2026-06-29 More stable belt tensioner
    [z-belt-tensioner.scad, z-belt-tensioner.stl]
2026-07-15 WIP strain gauge; KiCad docs
    [strain-gauge-interface.scad]
2026-07-26 Strain gauge adjustments; Y rod mount properly traps its nut
    [shared-dims.scad, strain-gauge-interface.scad, strain-gauge-interface.stl, y-rod-mount-A.stl, y-rod-mount-B.stl, y-rod-mount-C.stl, y-rod-mount-D.stl, y-rod-mount.scad]
2026-07-26 Nut trap adjustments
    [x-rod-sled.scad, y-rod-mount-A.stl, y-rod-mount-B.stl, y-rod-mount-C.stl, y-rod-mount-D.stl, y-rod-mount.scad]
